sktr834/Glamour_Predprof_2024/Дизайн приложения/Основной_экран.jpg

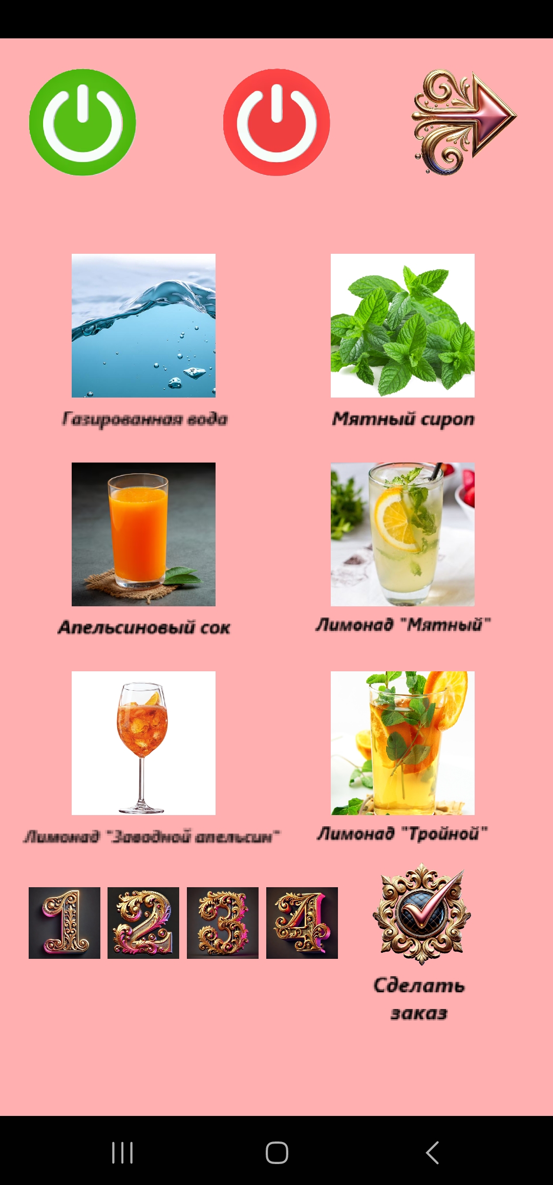
Дизайн приложения/Основной_экран.jpg
