sktr834/Glamour_Predprof_2024/3D-модели/Рендеры/IMG_0298.JPG

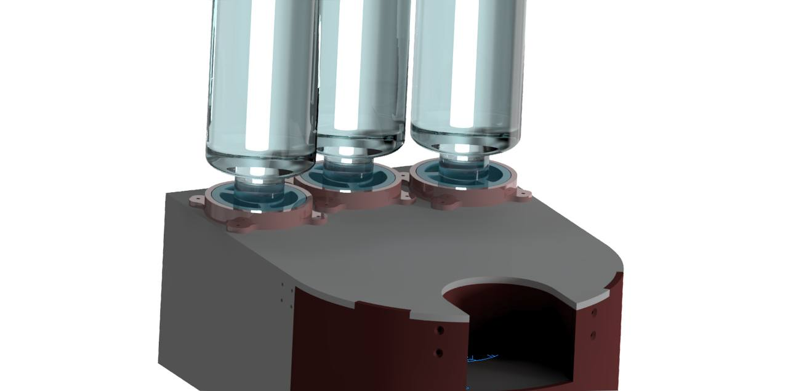
3D-модели/Рендеры/IMG_0298.JPG
