sktr834/Glamour_Predprof_2024/ПО/State machine.pdf

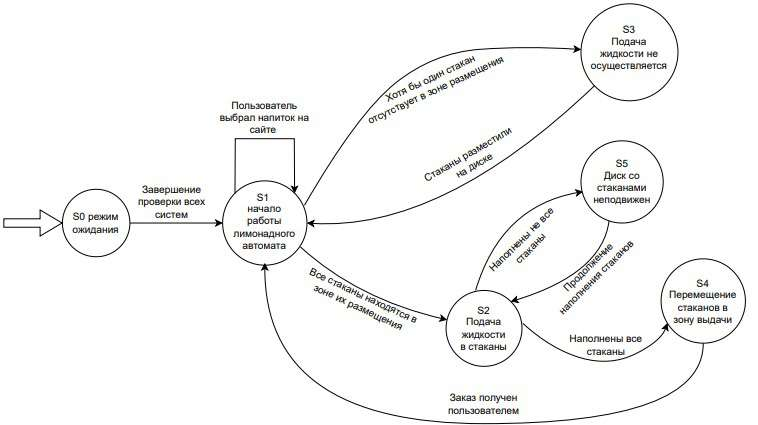
[picture p3: figure]
