sktr834/Glamour_Predprof_2024/ПО/блок схема.pdf

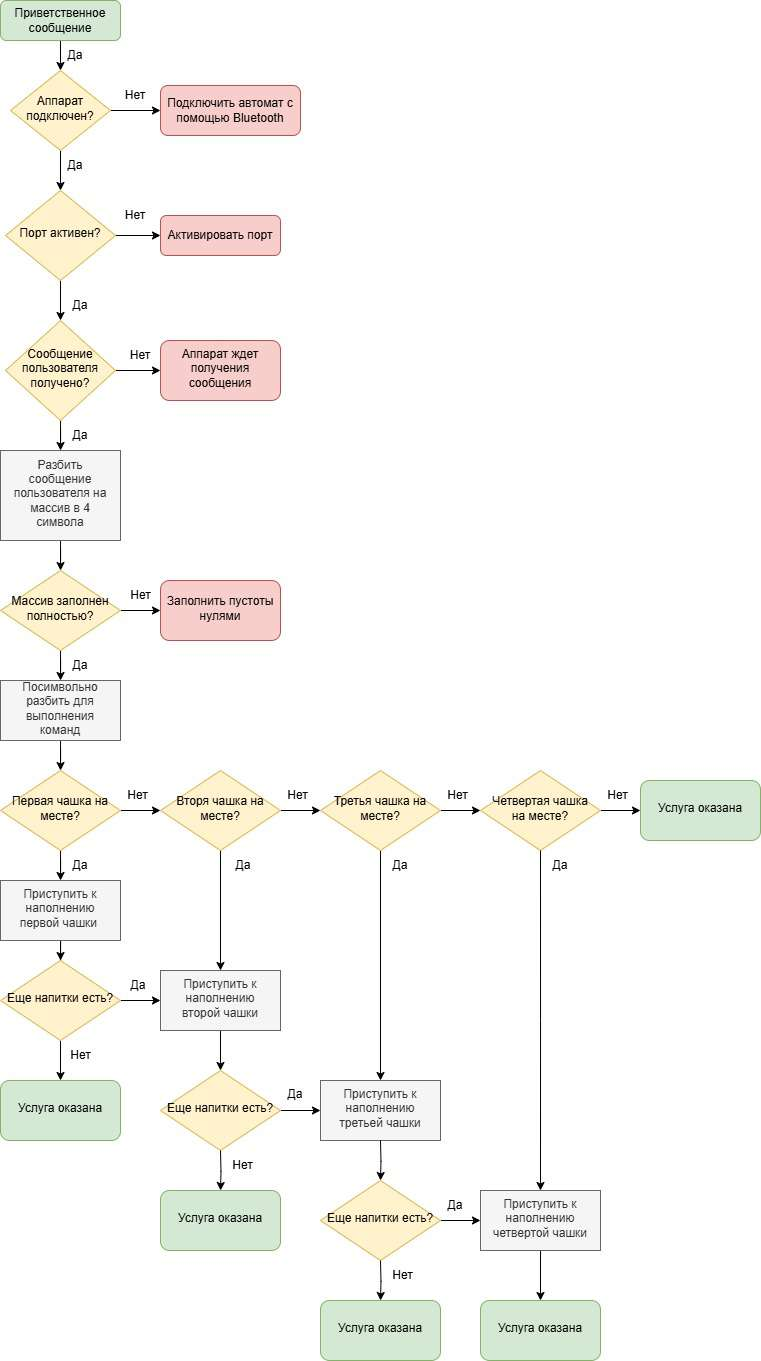
[picture p4: page 1]
