sktr834/Glamour_Predprof_2024/ПО/Диаграмма последовательности.pdf

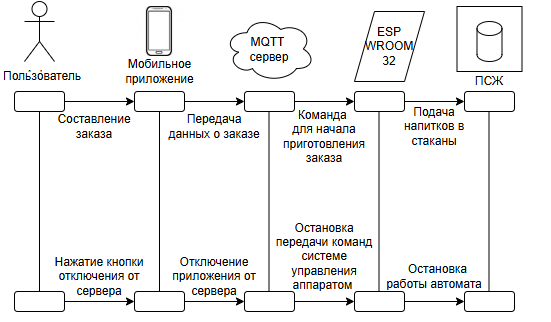
[picture p5: figure]
