sktr834/Glamour_Predprof_2024/Электроника/Монтажная схема.pdf

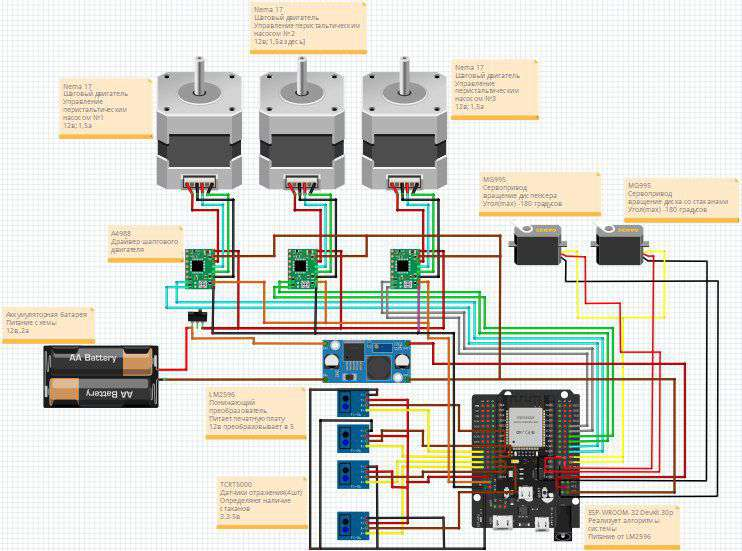
[picture p6: figure]
