sktr834/Glamour_Predprof_2024/3D-модели/Рендеры/IMG_0249.PNG

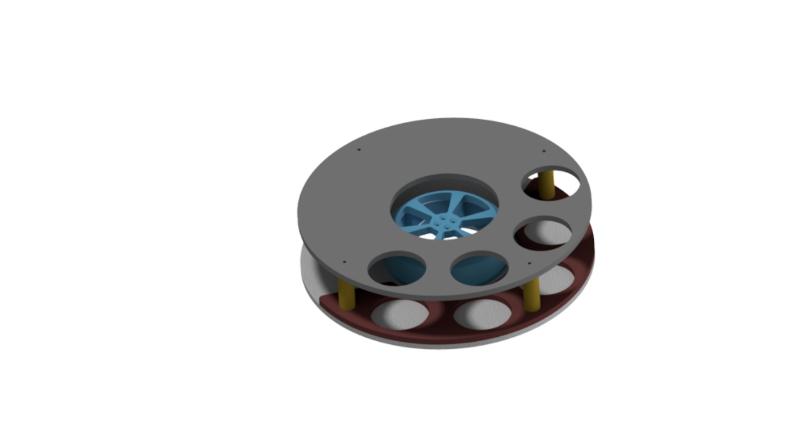
3D-модели/Рендеры/IMG_0249.PNG
