sktr834/Glamour_Predprof_2024/3D-модели/Рендеры/IMG_0294.BMP

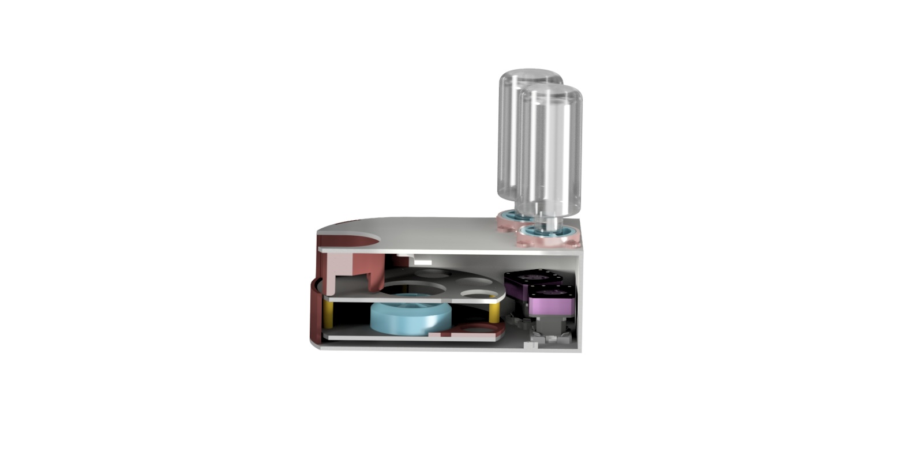
3D-модели/Рендеры/IMG_0294.BMP
