sktr834/Glamour_Predprof_2024/Дизайн приложения/Начальный_экран.jpg

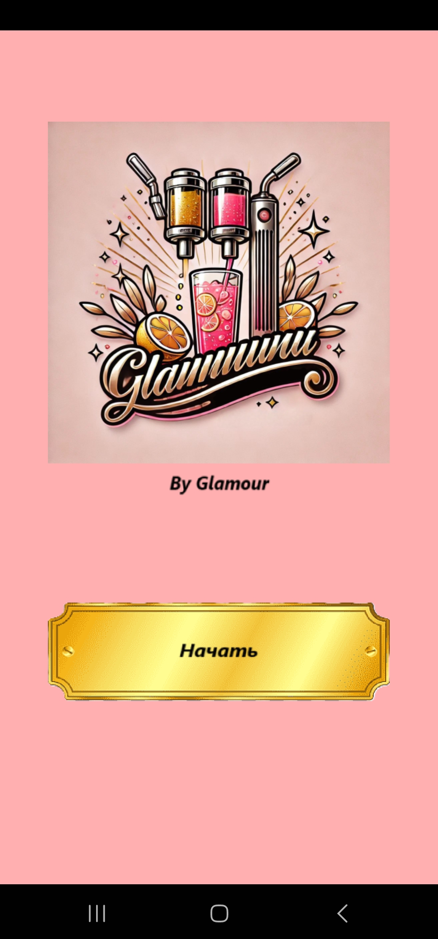
Дизайн приложения/Начальный_экран.jpg
