sktr834/Glamour_Predprof_2024/ПО/Структурная схема.png

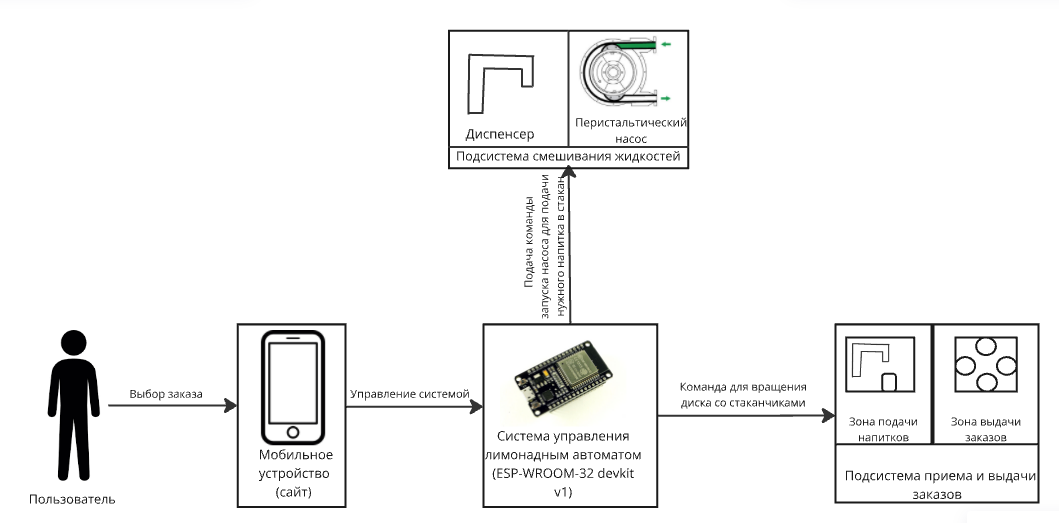
ПО/Структурная схема.png
