sktr834/Glamour_Predprof_2024/3D-модели/Поворотный_модуль.stp

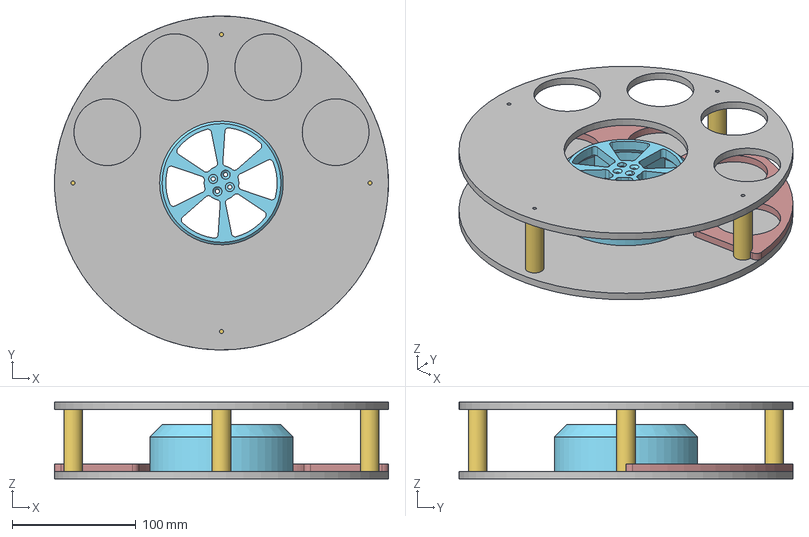
[picture p16: CAD file, 2025-02-10]
3D-модели/Поворотный_модуль.stp
270.0 x 269.9 x 62.0 mm
Диск_опорный
Фиксатор
Стойка x 4
Диск_фиксирующий
Переходник
