sktr834/Glamour_Predprof_2024/3D-модели/Основание бутылки.stp

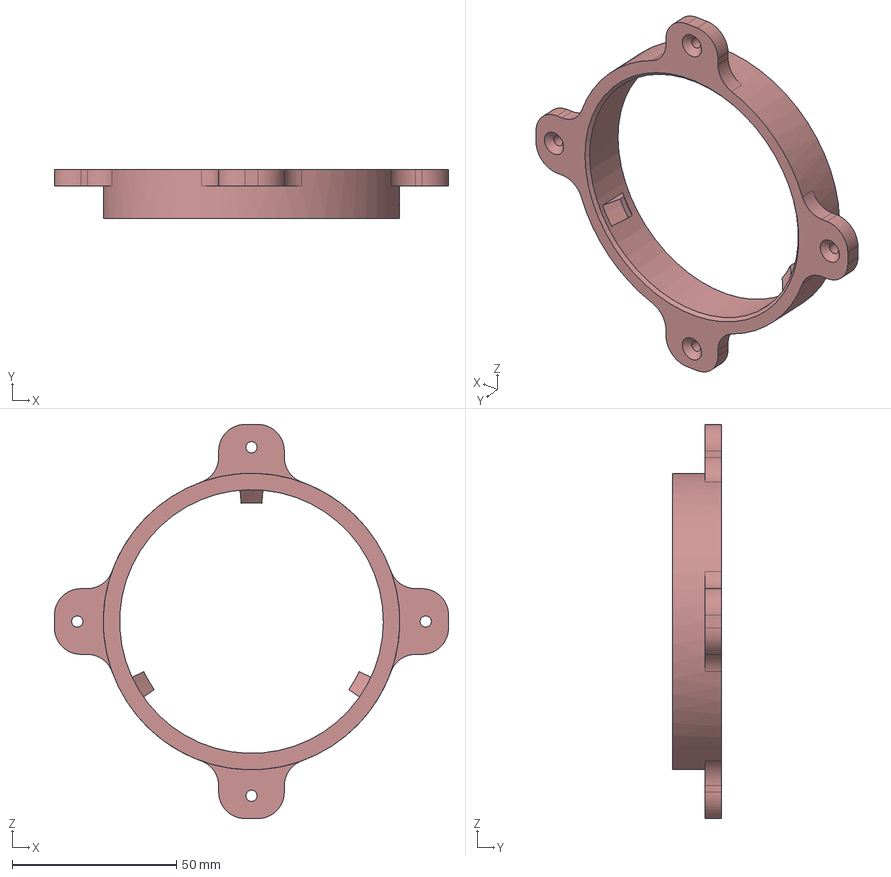
[picture p17: CAD file, 2025-02-10]
3D-модели/Основание бутылки.stp
120.0 x 15.0 x 120.0 mm
