sktr834/Glamour_Predprof_2024/3D-модели/Основание нижнее.stp

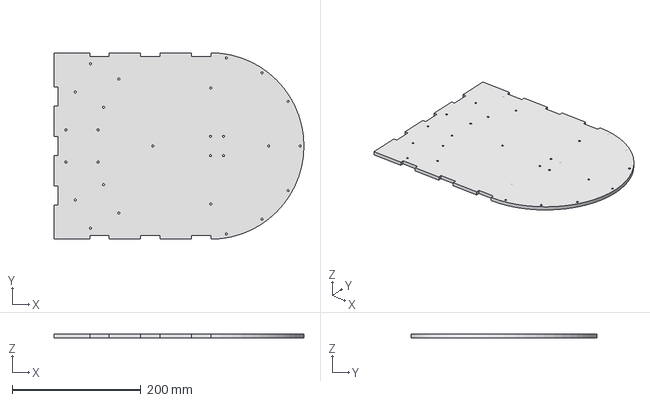
[picture p18: CAD file, 2025-02-10]
3D-модели/Основание нижнее.stp
388.8 x 290.0 x 6.00 mm
