sktr834/Glamour_Predprof_2024/3D-модели/Упор_В2.stp

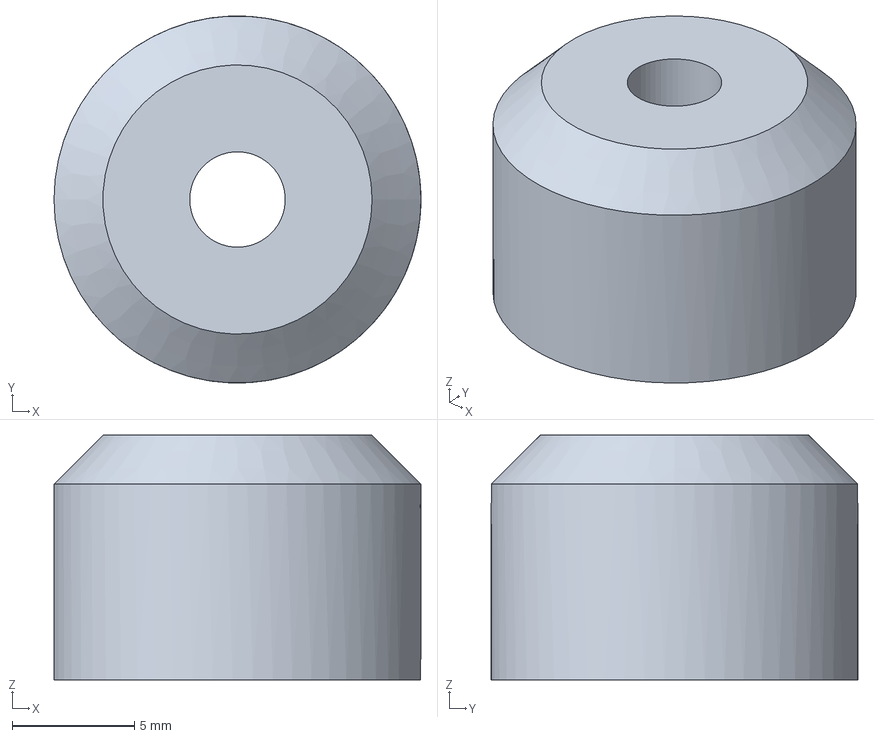
[picture p19: CAD file, 2025-02-10]
3D-модели/Упор_В2.stp
15.0 x 15.0 x 10.0 mm
