sktr834/Glamour_Predprof_2024/3D-модели/Стенка боковая.stp

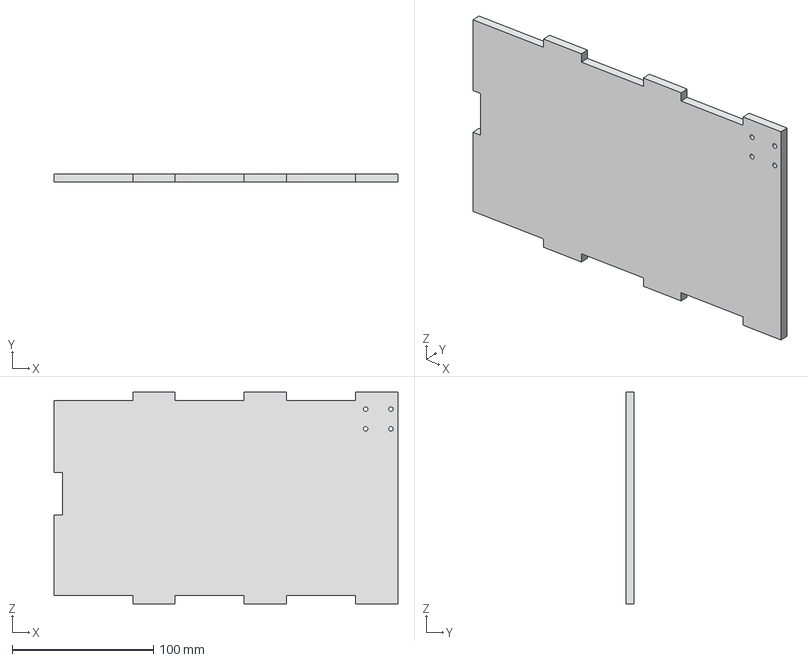
[picture p20: CAD file, 2025-02-10]
3D-модели/Стенка боковая.stp
243.8 x 6.00 x 150.0 mm
