sktr834/Glamour_Predprof_2024/3D-модели/Фиксатор_сервопривода.stp

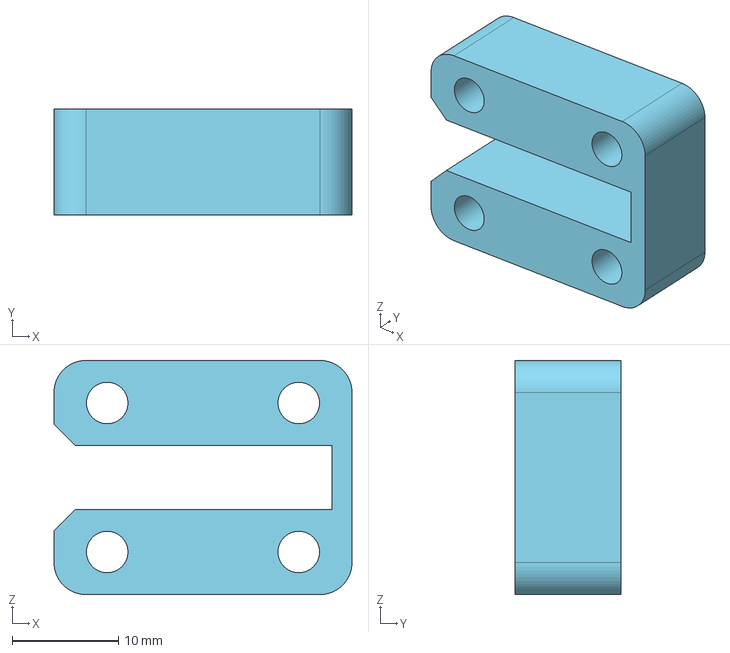
[picture p21: CAD file, 2025-02-10]
3D-модели/Фиксатор_сервопривода.stp
28.0 x 10.0 x 22.0 mm
