sktr834/Glamour_Predprof_2024/3D-модели/Фиксатор.stp

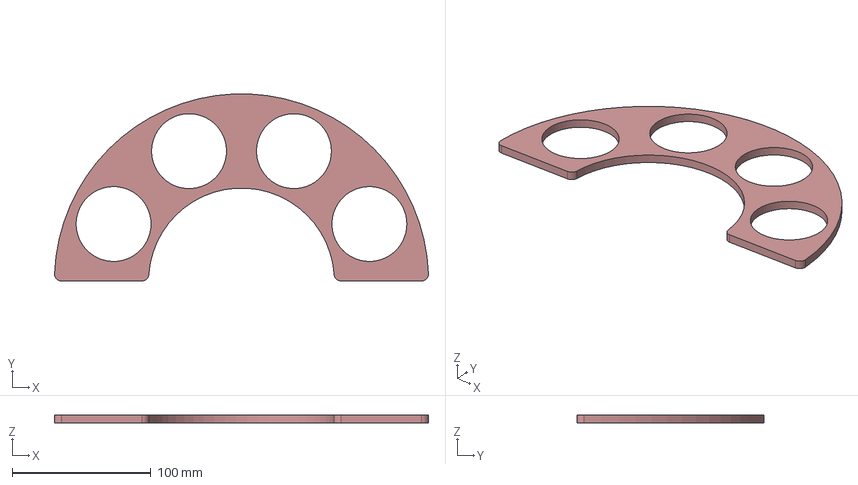
[picture p22: CAD file, 2025-02-10]
3D-модели/Фиксатор.stp
269.8 x 134.9 x 6.00 mm
