sktr834/Glamour_Predprof_2024/3D-модели/Стакан.stp

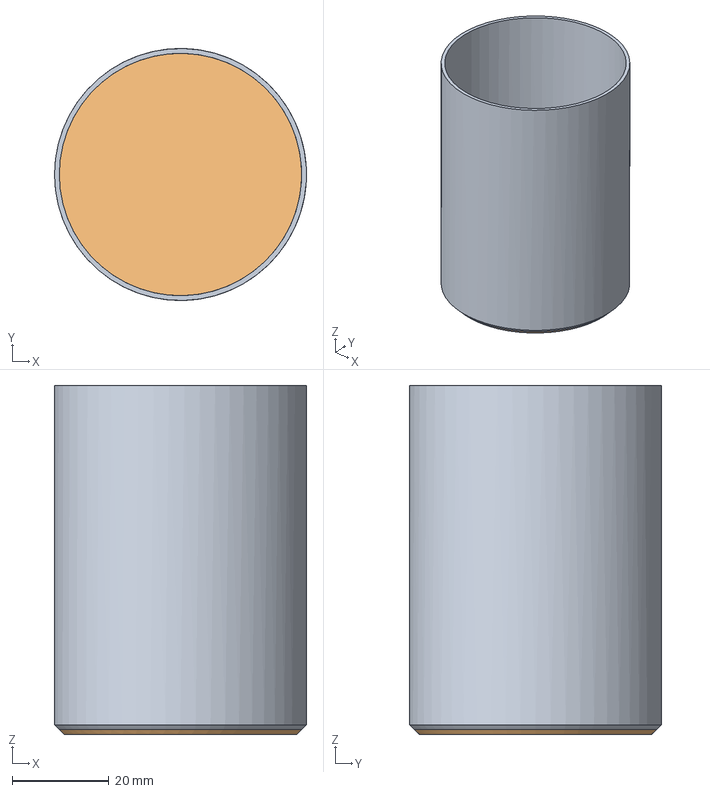
[picture p23: CAD file, 2025-02-10]
3D-модели/Стакан.stp
52.0 x 52.0 x 72.0 mm
