sktr834/Glamour_Predprof_2024/3D-модели/Основание верхнее.stp

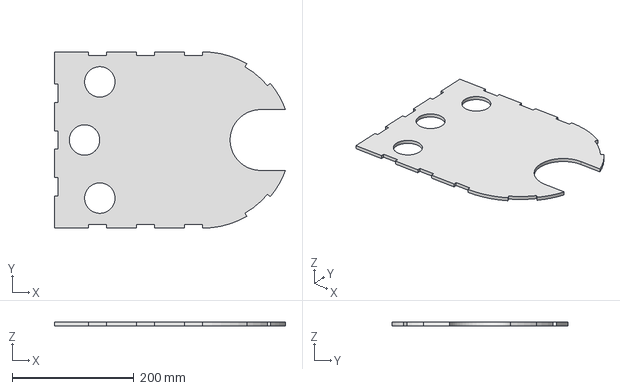
[picture p24: CAD file, 2025-02-10]
3D-модели/Основание верхнее.stp
379.9 x 290.0 x 6.00 mm
