sktr834/Glamour_Predprof_2024/3D-модели/переходник бутылки.stp

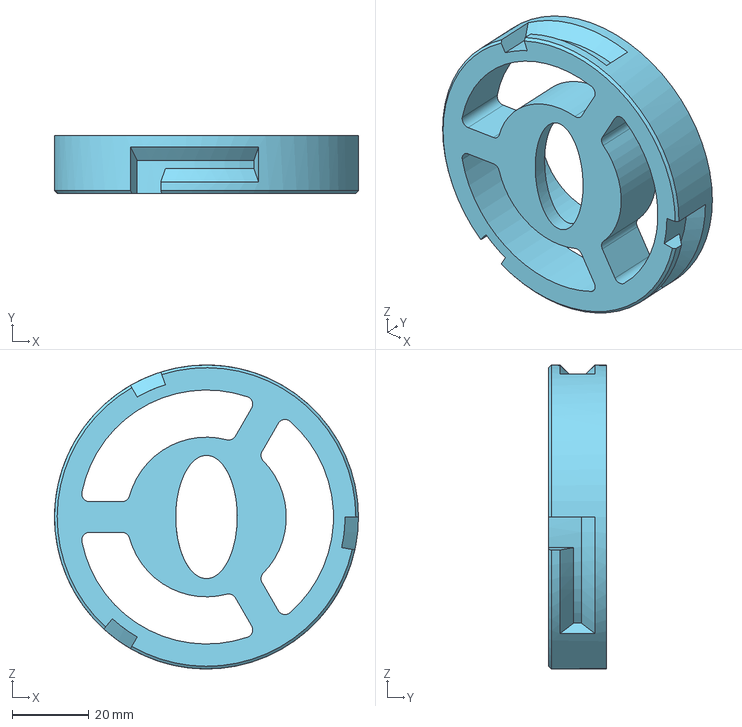
[picture p25: CAD file, 2025-02-10]
3D-модели/переходник бутылки.stp
79.0 x 15.0 x 79.0 mm
