sktr834/Glamour_Predprof_2024/3D-модели/Стойка.stp

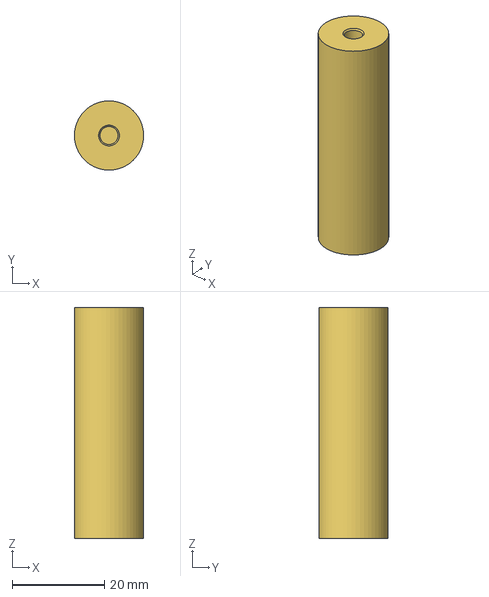
[picture p26: CAD file, 2025-02-10]
3D-модели/Стойка.stp
15.0 x 15.0 x 50.0 mm
