sktr834/Glamour_Predprof_2024/3D-модели/Стенка задняя.stp

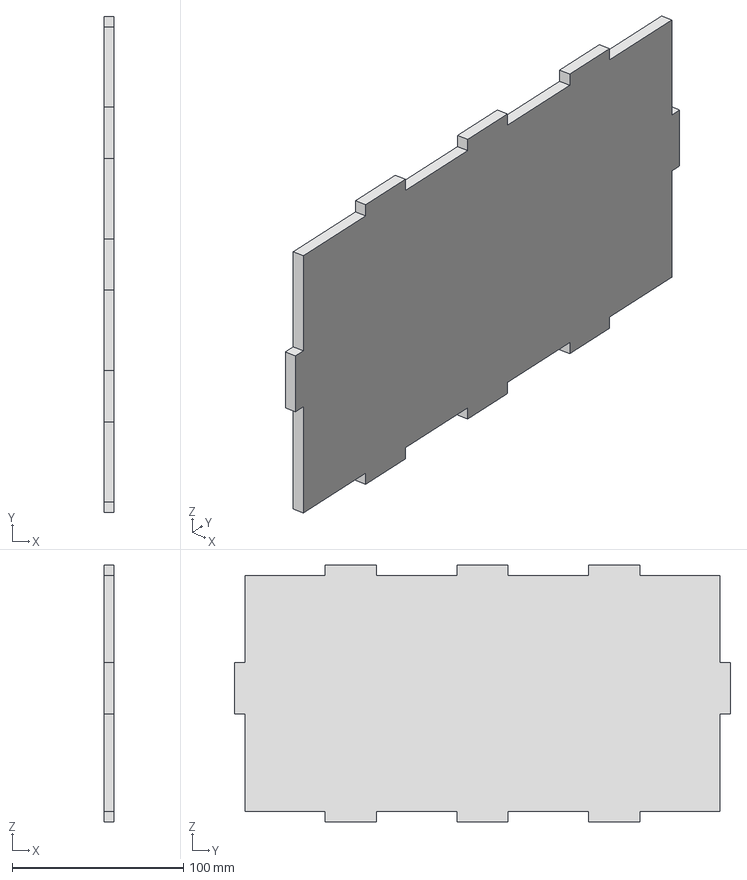
[picture p27: CAD file, 2025-02-10]
3D-модели/Стенка задняя.stp
6.00 x 290.0 x 150.0 mm
