sktr834/Glamour_Predprof_2024/3D-модели/узел бутылки.stp

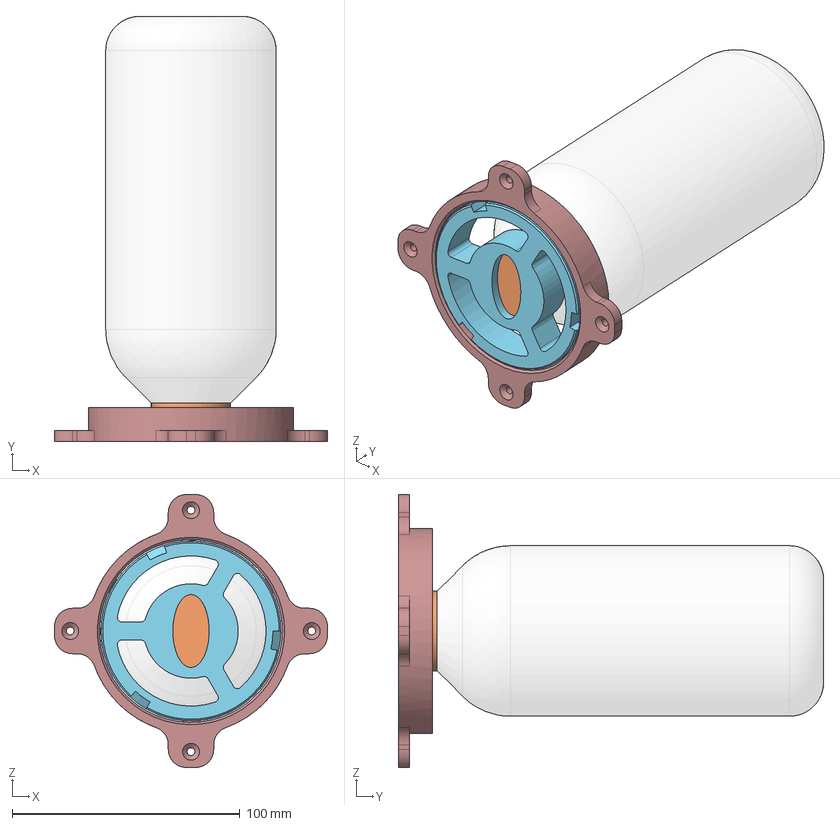
[picture p28: CAD file, 2025-02-10]
3D-модели/узел бутылки.stp
120.0 x 187.0 x 120.0 mm
Основание бутылки
переходник бутылки
Бутылка_2
