sktr834/Glamour_Predprof_2024/3D-модели/Переходник.stp

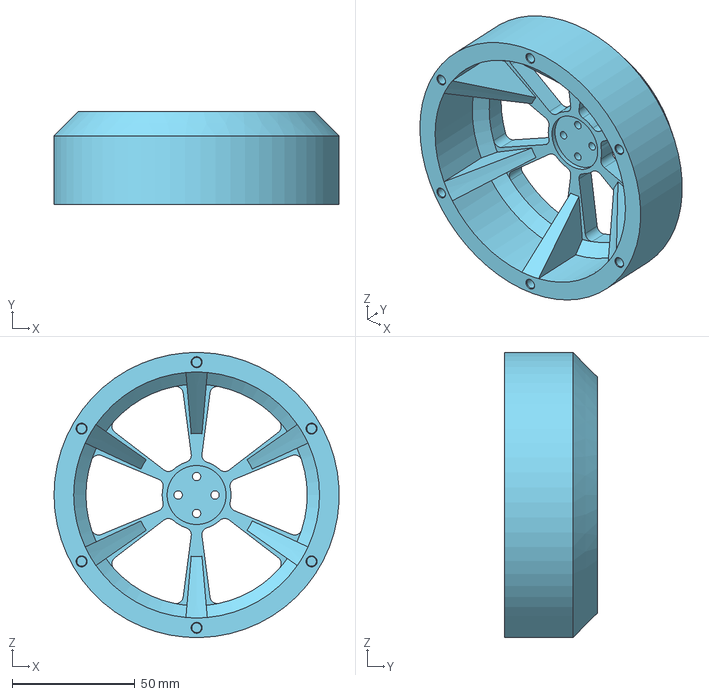
[picture p29: CAD file, 2025-02-10]
3D-модели/Переходник.stp
115.9 x 38.0 x 116.0 mm
