sktr834/Glamour_Predprof_2024/3D-модели/Кожух правый.stp

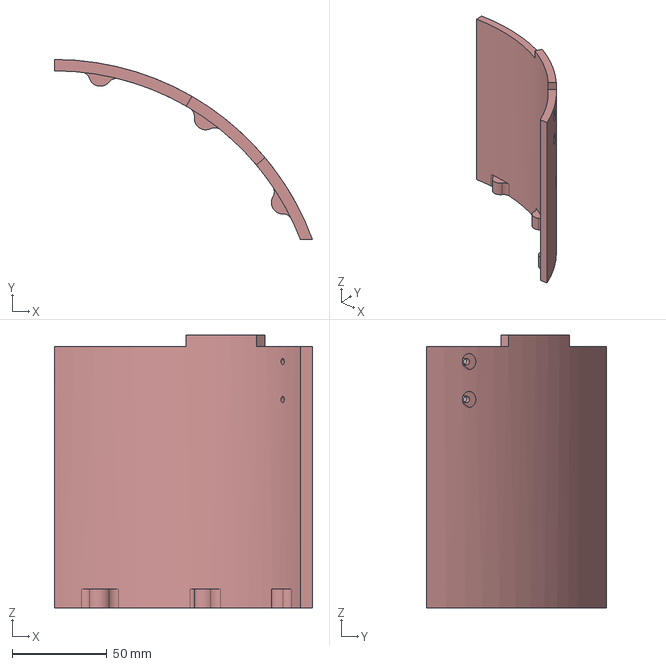
[picture p30: CAD file, 2025-02-10]
3D-модели/Кожух правый.stp
136.1 x 95.0 x 144.0 mm
