sktr834/Glamour_Predprof_2024/3D-модели/Abec 7 608 zz.stp

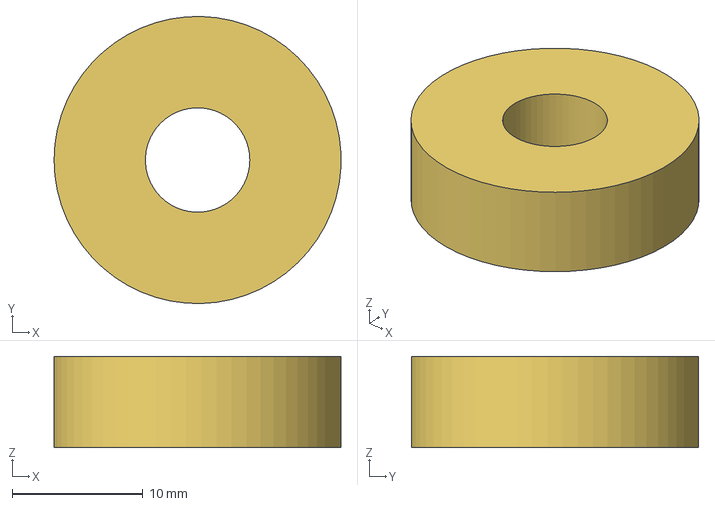
[picture p31: CAD file, 2025-02-10]
3D-модели/Abec 7 608 zz.stp
22.0 x 22.0 x 7.00 mm
