sktr834/Glamour_Predprof_2024/3D-модели/Диск_фиксирующий.stp

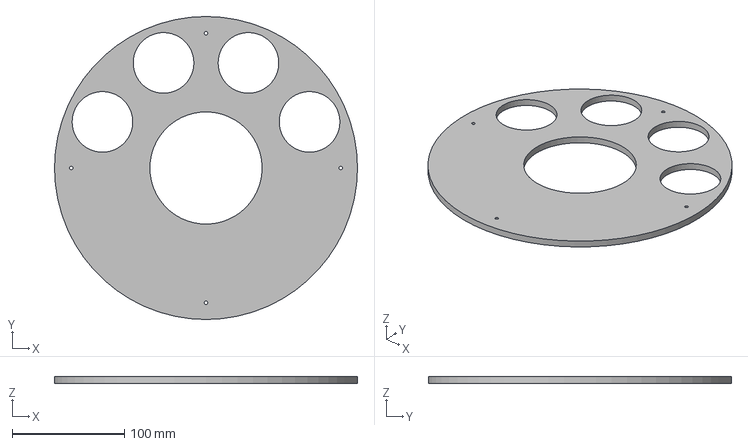
[picture p32: CAD file, 2025-02-10]
3D-модели/Диск_фиксирующий.stp
270.0 x 270.0 x 6.00 mm
