sktr834/Glamour_Predprof_2024/3D-модели/1.stp

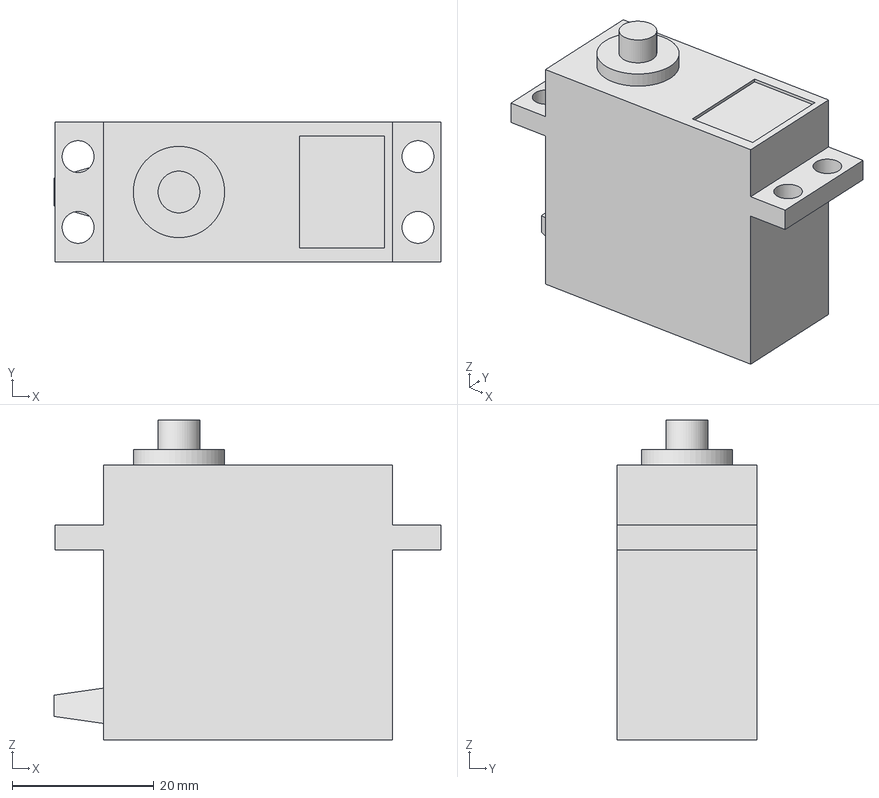
[picture p33: CAD file, 2025-02-10]
3D-модели/1.stp
54.6 x 19.8 x 45.1 mm
