sktr834/Glamour_Predprof_2024/3D-модели/Кожухзадний.stp

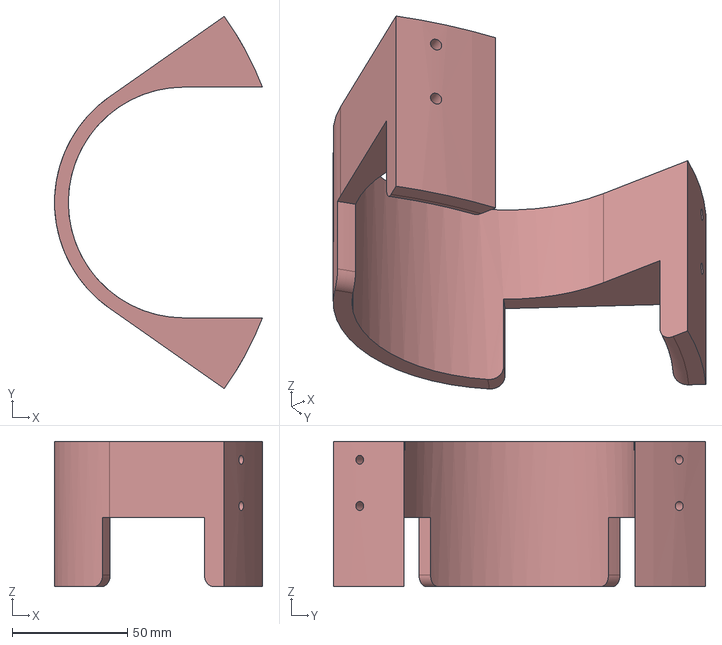
[picture p34: CAD file, 2025-02-10]
3D-модели/Кожухзадний.stp
90.2 x 161.3 x 63.0 mm
