sktr834/Glamour_Predprof_2024/3D-модели/Бутылка_2.stp

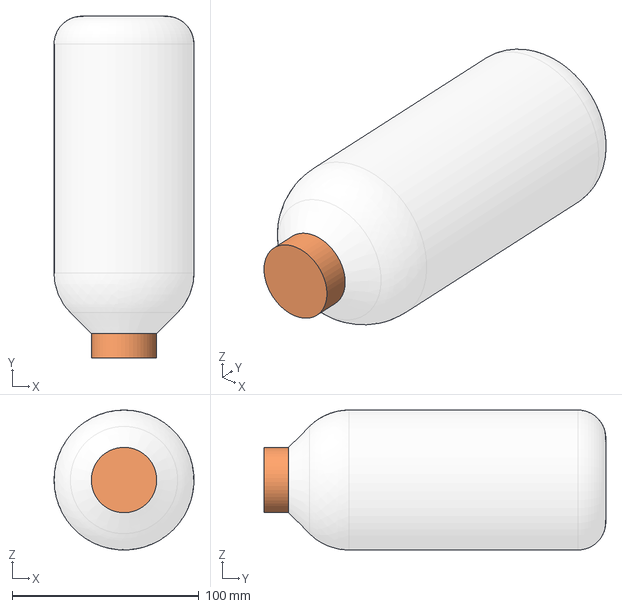
[picture p35: CAD file, 2025-02-10]
3D-модели/Бутылка_2.stp
75.0 x 183.0 x 75.0 mm
