sktr834/Glamour_Predprof_2024/3D-модели/MG995.stp

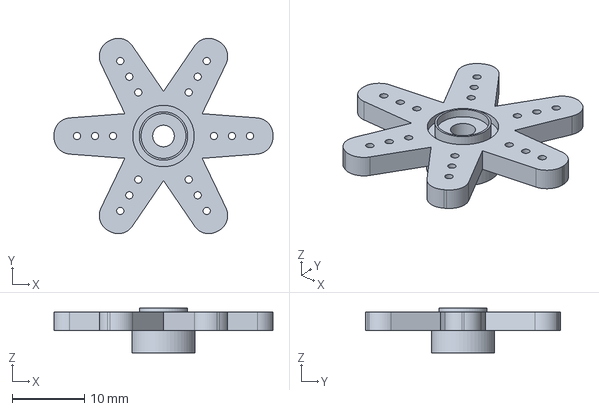
[picture p36: CAD file, 2025-02-10]
3D-модели/MG995.stp
30.4 x 27.1 x 6.23 mm
