sktr834/Glamour_Predprof_2024/3D-модели/Диск_опорный.stp

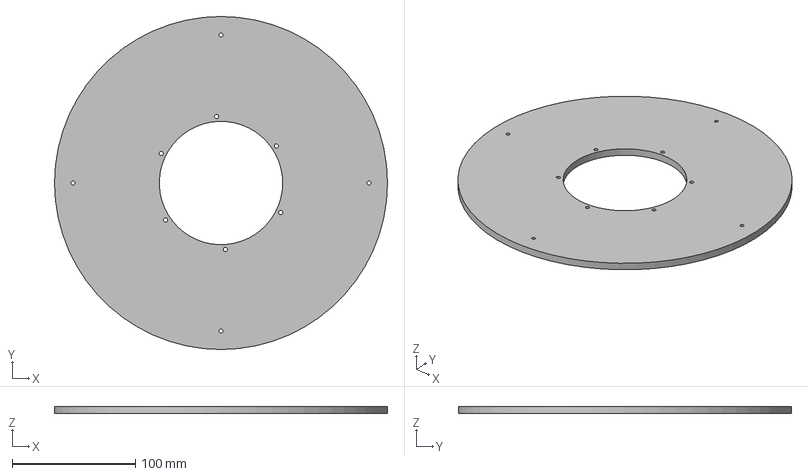
[picture p37: CAD file, 2025-02-10]
3D-модели/Диск_опорный.stp
270.0 x 270.0 x 6.00 mm
