sktr834/Glamour_Predprof_2024/3D-модели/Кожух малый.stp

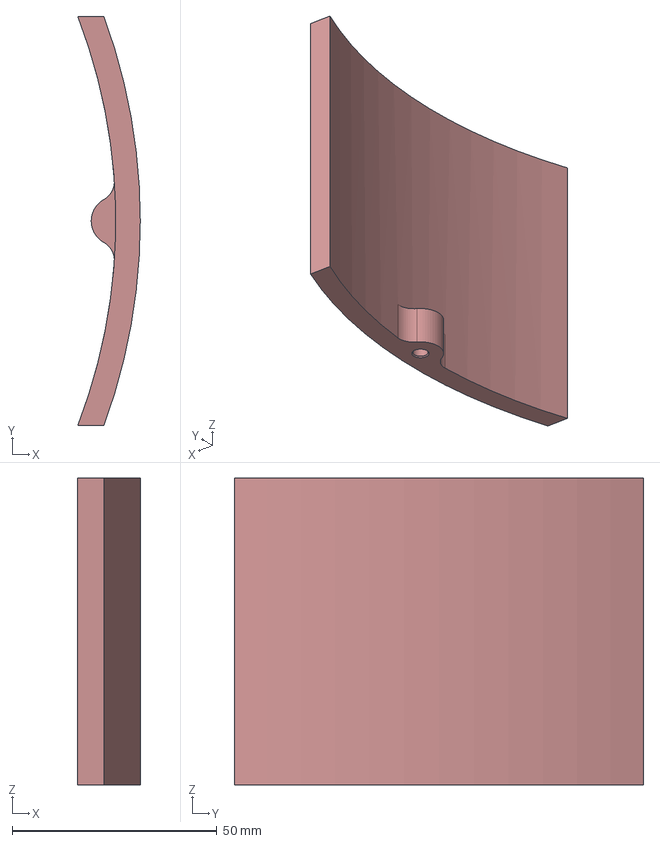
[picture p38: CAD file, 2025-02-10]
3D-модели/Кожух малый.stp
15.3 x 100.0 x 75.0 mm
