sktr834/Glamour_Predprof_2024/3D-модели/SG90.stp

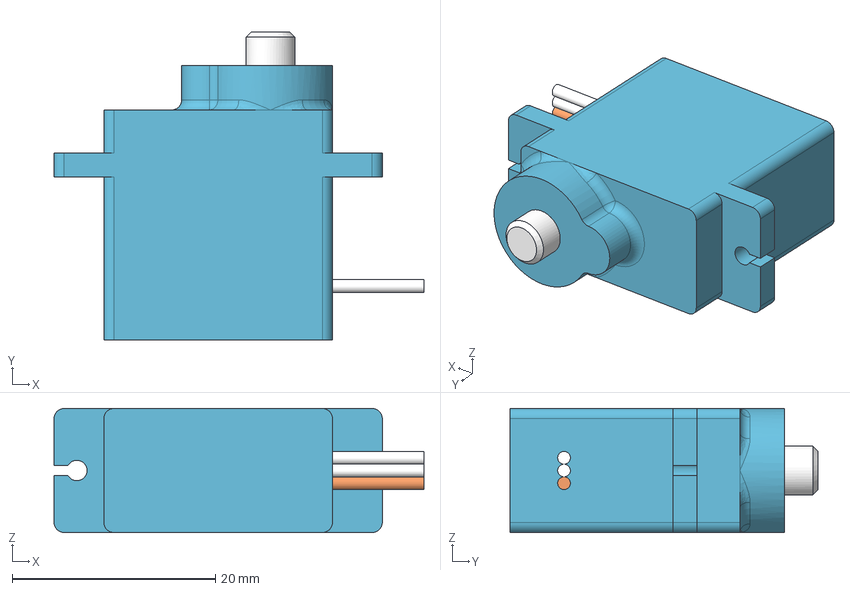
[picture p39: CAD file, 2025-02-10]
3D-модели/SG90.stp
36.4 x 30.3 x 12.2 mm
