sktr834/Glamour_Predprof_2024/3D-модели/Корпус.stp

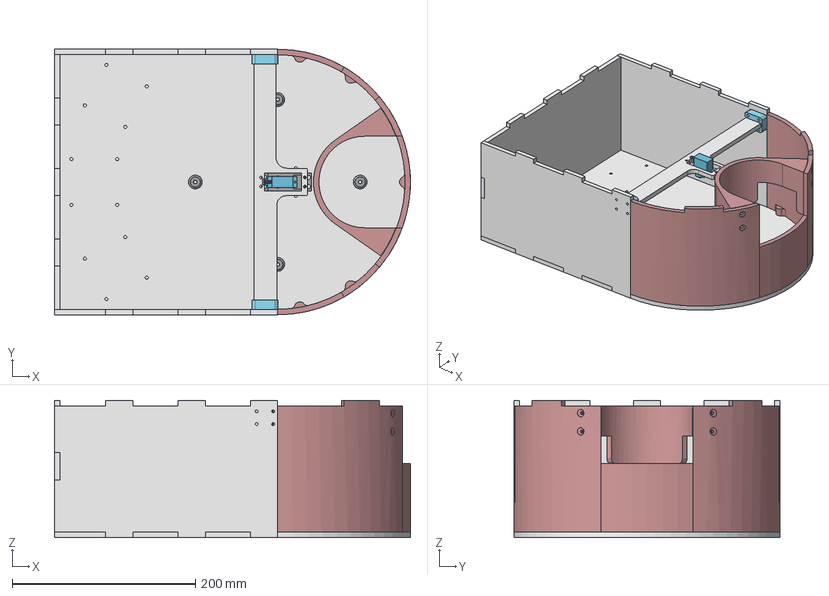
[picture p40: CAD file, 2025-02-10]
3D-модели/Корпус.stp
388.8 x 290.0 x 150.0 mm
Основание нижнее
Кронштейн сервопривода3 101
Стенка боковая x 2
Стенка задняя
Кожух левый
Кожух малый
Кожух правый
Кожухзадний
Фиксатор_сервопривода x 2
SG90
Упор_В2 x 4
