sktr834/Glamour_Predprof_2024/3D-модели/Кронштейн сервопривода.stp

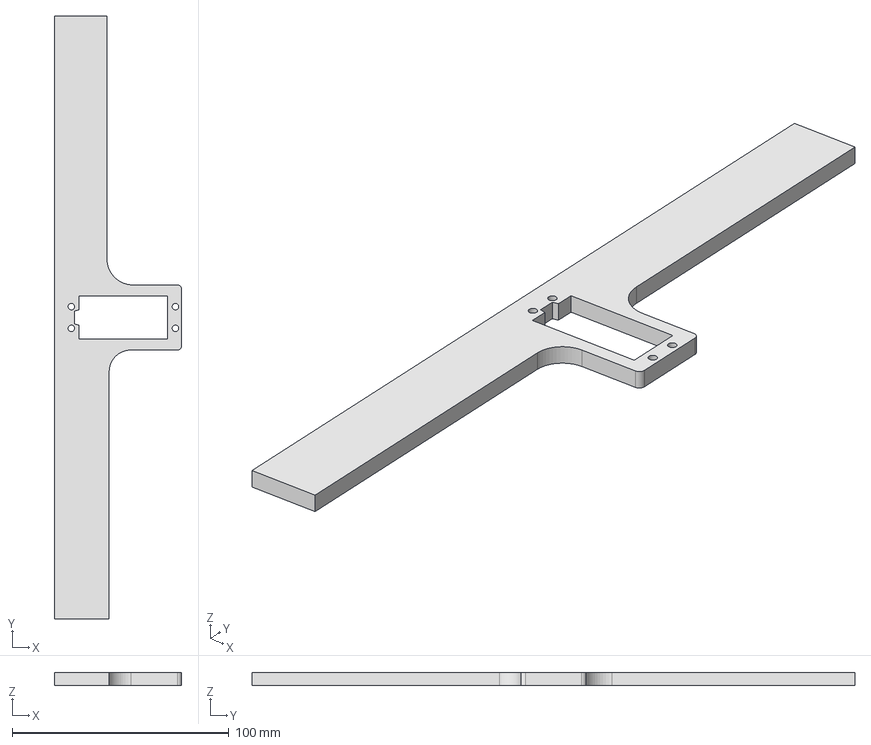
[picture p41: CAD file, 2025-02-10]
3D-модели/Кронштейн сервопривода.stp
58.6 x 278.0 x 6.00 mm
