sktr834/Glamour_Predprof_2024/(list of files, cad)

Other CAD files:
3D-модели/2.stp
3D-модели/Кожух левый.stp
3D-модели/1.ipt
3D-модели/1.stl
3D-модели/2.ipt
3D-модели/2.stl
3D-модели/Abec 7 608 zz.ipt
3D-модели/Abec 7 608 zz.stl
3D-модели/Bolt.ipt
3D-модели/Bolt.stl
3D-модели/Bolt.stp
3D-модели/ISO 7046-1 - M3 x 20_ - 4.8 - H - ISO.stl
3D-модели/ISO 7046-1 - M3 x 20_ - 4.8 - H - ISO.stp
3D-модели/ISO 7046-1 - M3 x 8_ - 4.8 - H - ISO.stl
3D-модели/ISO 7046-1 - M3 x 8_ - 4.8 - H - ISO.stp
3D-модели/Itteration_4/Abec 7 608 zz.ipt
3D-модели/Itteration_4/ISO 7046-1 - M3 x 20_ - 4.8 - H - ISO.ipt
3D-модели/Itteration_4/ISO 7046-1 - M3 x 8_ - 4.8 - H - ISO.ipt
3D-модели/Itteration_4/OldVersions/Abec 7 608 zz.0002.ipt
3D-модели/Itteration_4/OldVersions/ISO 7046-1 - M3 x 20_ - 4.8 - H - ISO.0001.ipt
3D-модели/Itteration_4/OldVersions/ISO 7046-1 - M3 x 8_ - 4.8 - H - ISO.0001.ipt
3D-модели/Itteration_4/OldVersions/Pump_V3.0011.iam
3D-модели/Itteration_4/OldVersions/Pump_V3_Корпус.0006.iam
3D-модели/Itteration_4/OldVersions/Pump_V3_Корпус.0029.ipt
3D-модели/Itteration_4/OldVersions/Pump_V3_Основание.0006.ipt
3D-модели/Itteration_4/OldVersions/Pump_V3_Полумуфта.0016.ipt
3D-модели/Itteration_4/OldVersions/Pump_V4.0015.iam
3D-модели/Itteration_4/OldVersions/Pump_V4_Корпус.0007.iam
3D-модели/Itteration_4/OldVersions/Втулка.0003.ipt
3D-модели/Itteration_4/OldVersions/Крышка.0007.ipt
3D-модели/Itteration_4/OldVersions/Полумуфта.0013.ipt
3D-модели/Itteration_4/Pump_V3_Втулка.ipt
3D-модели/Itteration_4/Pump_V3_Основание.ipt
3D-модели/Itteration_4/Pump_V3_Полумуфта.ipt
3D-модели/Itteration_4/Pump_V4.iam
3D-модели/Itteration_4/Pump_V4_Корпус.iam
3D-модели/Itteration_4/Pump_V4_Корпус.ipt
3D-модели/Itteration_4/Pump_V4_Крышка.ipt
3D-модели/Itteration_4/Втулка Впаиваемая М3х4.2х5.ipt
3D-модели/MG995.iam
3D-модели/MG995.stl
3D-модели/SG90.ipt
3D-модели/SG90.stl
3D-модели/Бутылка_2.ipt
3D-модели/Бутылка_2.stl
3D-модели/Диск_опорный.ipt
3D-модели/Диск_опорный.stl
3D-модели/Диск_фиксирующий.ipt
3D-модели/Диск_фиксирующий.stl
3D-модели/Кожух левый.ipt
3D-модели/Кожух левый.stl
3D-модели/Кожух малый.ipt
3D-модели/Кожух малый.stl
3D-модели/Кожух правый.ipt
3D-модели/Кожух правый.stl
3D-модели/Кожухзадний.ipt
3D-модели/Кожухзадний.stl
3D-модели/Корпус.iam
3D-модели/Корпус.stl
3D-модели/Кронштейн сервопривода.ipt
3D-модели/Кронштейн сервопривода.stl
3D-модели/Основание бутылки.ipt
3D-модели/Основание бутылки.stl
3D-модели/Основание верхнее.ipt
3D-модели/Основание верхнее.stl
3D-модели/Основание нижнее.ipt
3D-модели/Основание нижнее.stl
3D-модели/Переходник.ipt
3D-модели/Переходник.stl
3D-модели/Поворотный_модуль.iam
3D-модели/Поворотный_модуль.stl
3D-модели/Стакан.ipt
3D-модели/Стакан.stl
3D-модели/Стенка боковая.ipt
3D-модели/Стенка боковая.stl
3D-модели/Стенка задняя.ipt
3D-модели/Стенка задняя.stl
3D-модели/Стойка.ipt
3D-модели/Стойка.stl
3D-модели/Упор_В2.ipt
3D-модели/Упор_В2.stl
3D-модели/Фиксатор.ipt
3D-модели/Фиксатор.stl
3D-модели/Фиксатор_сервопривода.ipt
3D-модели/Фиксатор_сервопривода.stl
3D-модели/лимонадный автомат.iam
3D-модели/переходник бутылки.ipt
3D-модели/переходник бутылки.stl
3D-модели/узел бутылки (1).stl
3D-модели/узел бутылки (1).stp
3D-модели/узел бутылки.iam
3D-модели/узел бутылки.stl
