sktr834/Glamour_Predprof_2024/Электроника/Принципиальная схема.pdf

A | A
B | B
C | C
D | D

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
### TITLE:

Sheet_1 | REV: 1.0
Date: | 2024-04-20

### Sheet: 1/1

## Drawn By: pycckuu_xumuk

## Company: Your Company

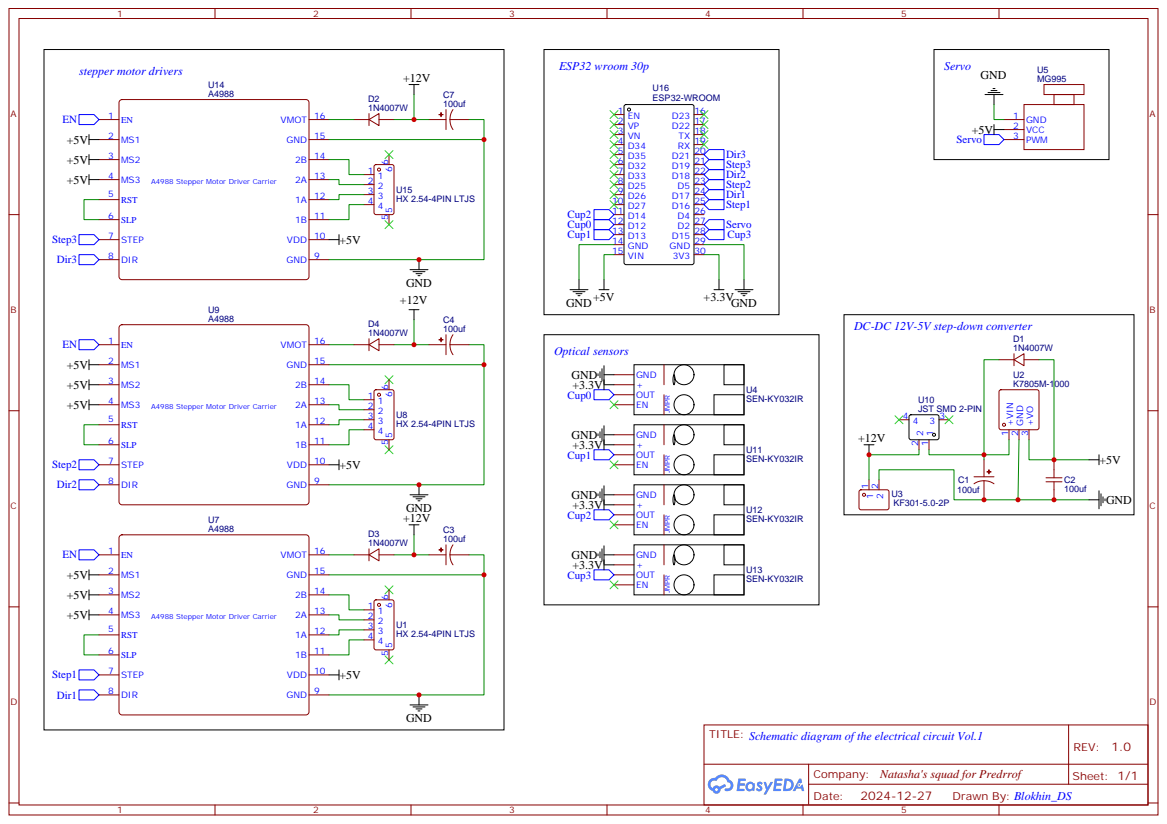
[picture p42: page 2]

A4988 Stepper Motor Driver Carrier

DC-DC 12V-5V step-down converter

TITLE:
Schematic diagram of the electrical circuit Vol.1

Company: Natasha's squad for Predrrof
