sktr834/Glamour_Predprof_2024/ПО/Usecase.pdf

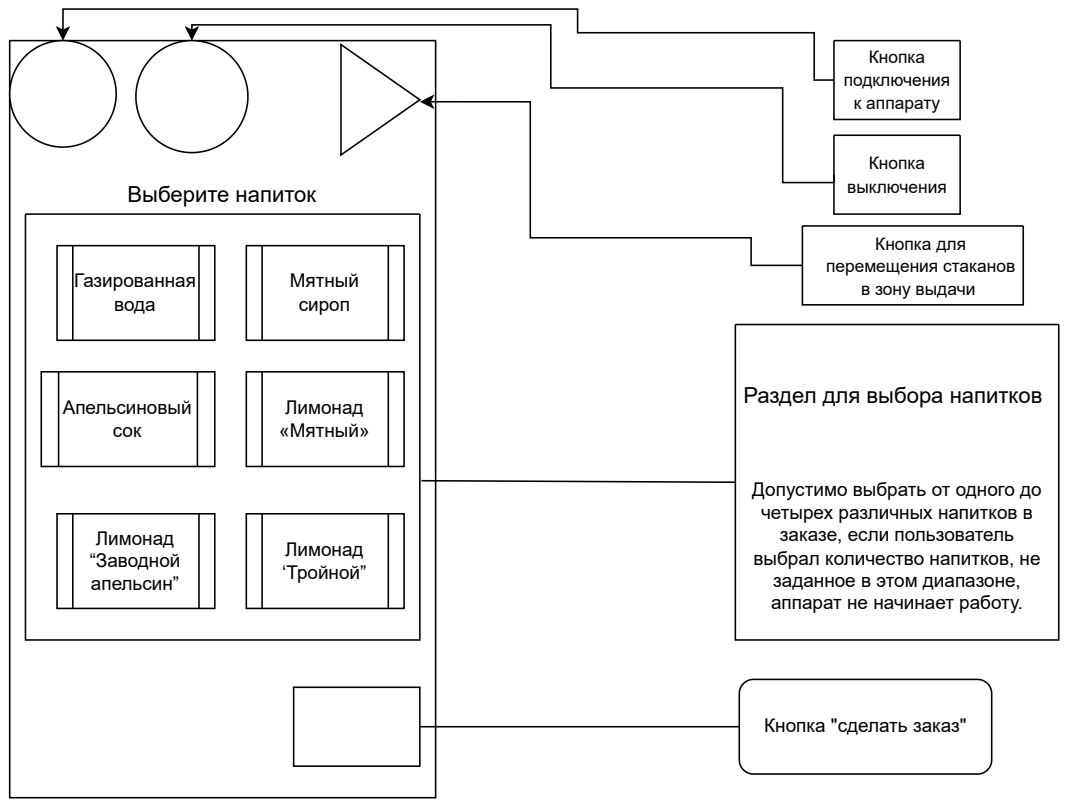
[picture p43: page 1]
Выберите напиток; Лимонад “Заводной апельсин”; Газированная вода; Мятный сироп; Апельсиновый сок; Лимонад «Мятный»; Лимонад ‘Тройной”; Кнопка подключения к аппарату; Кнопка выключения; Кнопка для перемещения стаканов в зону выдачи

Раздел для выбора напитков

Допустимо выбрать от одного до
четырех различных напитков в
заказе, если пользователь
выбрал количество напитков, не
заданное в этом диапазоне,
аппарат не начинает работу.

Кнопка "сделать заказ"
