sktr834/Glamour_Predprof_2024/(list of files, drawings)

Other design files:
Электроника/Монтажная схема.fzz
